OpenMagnetics/Lab/hardware/relay-board-revB/renders/07_closeup_dut_clamp.png

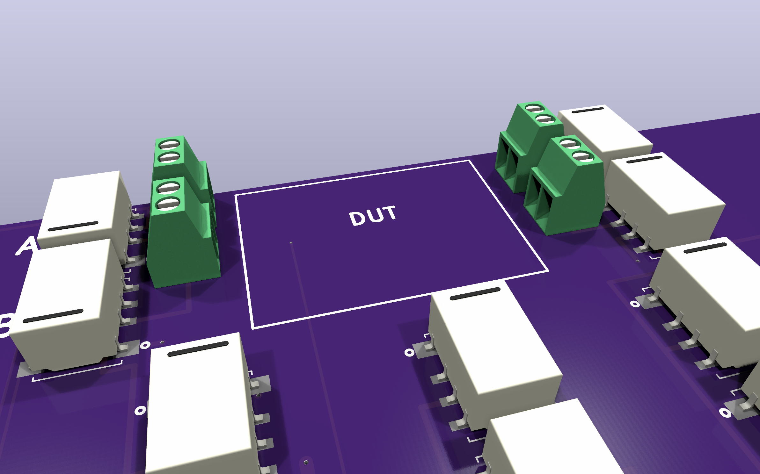
hardware/relay-board-revB/renders/07_closeup_dut_clamp.png
