OpenMagnetics/Lab/hardware/relay-board-revB/renders/03_top.png

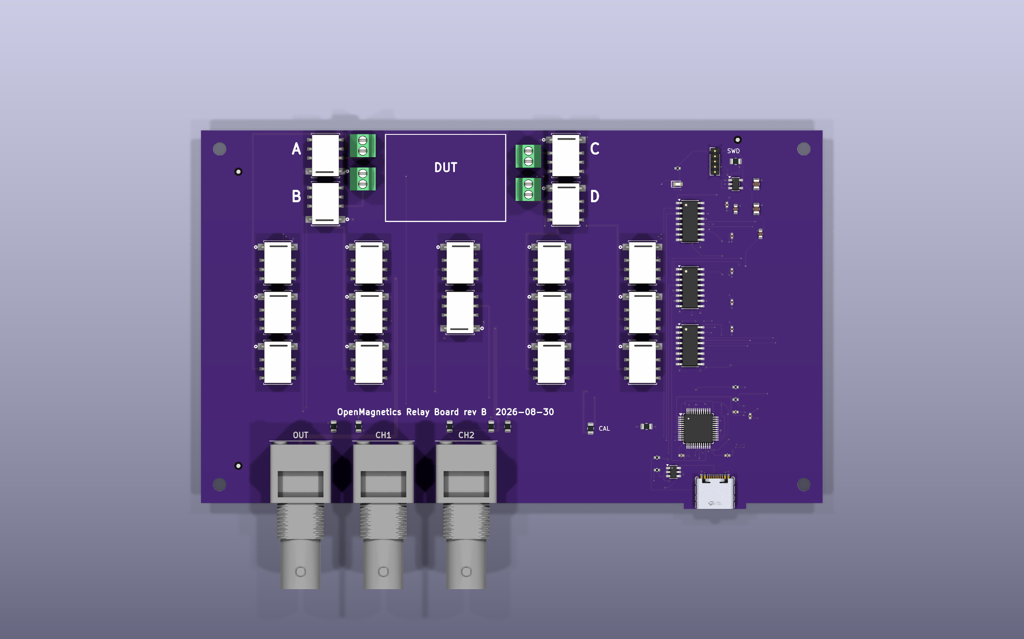
hardware/relay-board-revB/renders/03_top.png
