OpenMagnetics/Lab/hardware/B-WIC-Adapter/board_render.png

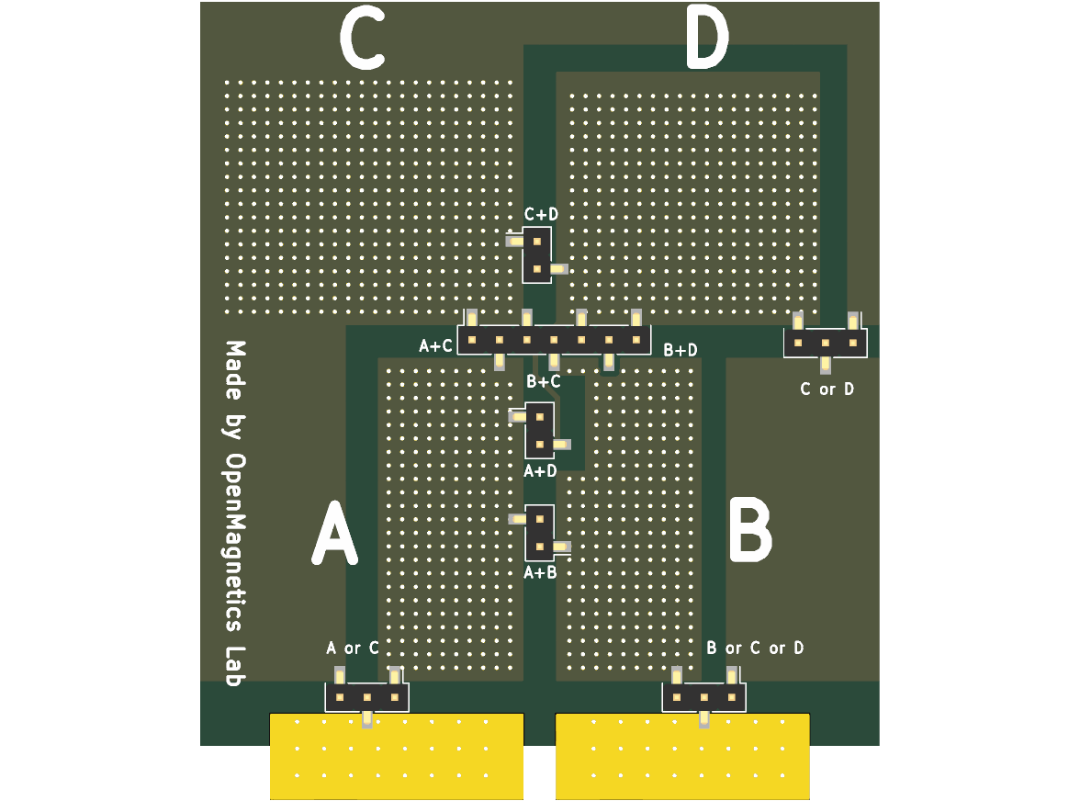
hardware/B-WIC-Adapter/board_render.png
