OpenMagnetics/Lab/hardware/B-WIC-Adapter/relay_board_render.png

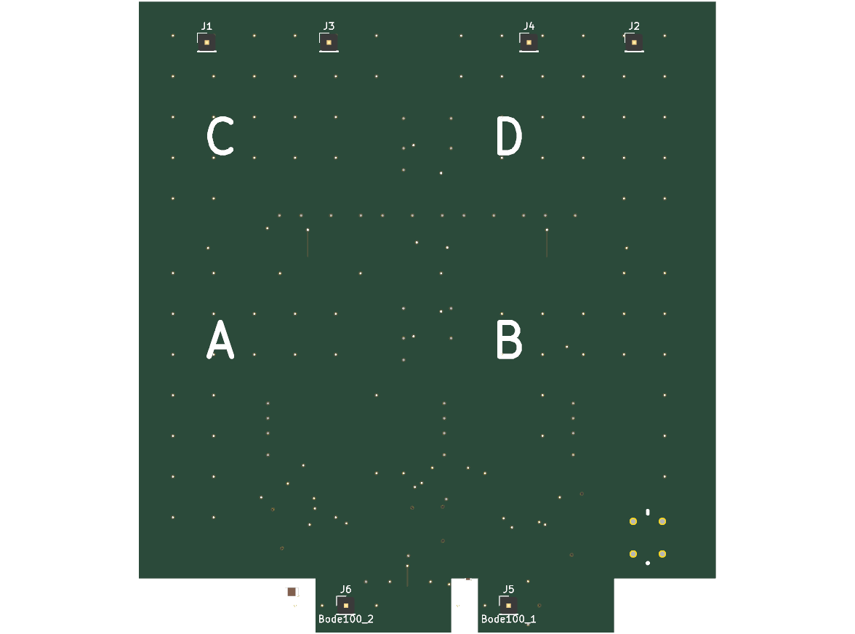
hardware/B-WIC-Adapter/relay_board_render.png
