OpenMagnetics/Lab/hardware/relay-board-revB/board_render_final.png

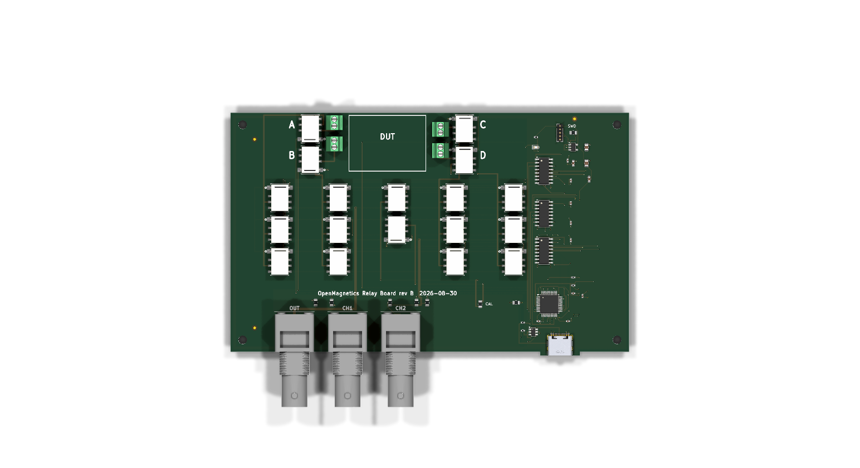
hardware/relay-board-revB/board_render_final.png
