OpenMagnetics/Lab/hardware/relay-board-revB/board_render_full.png

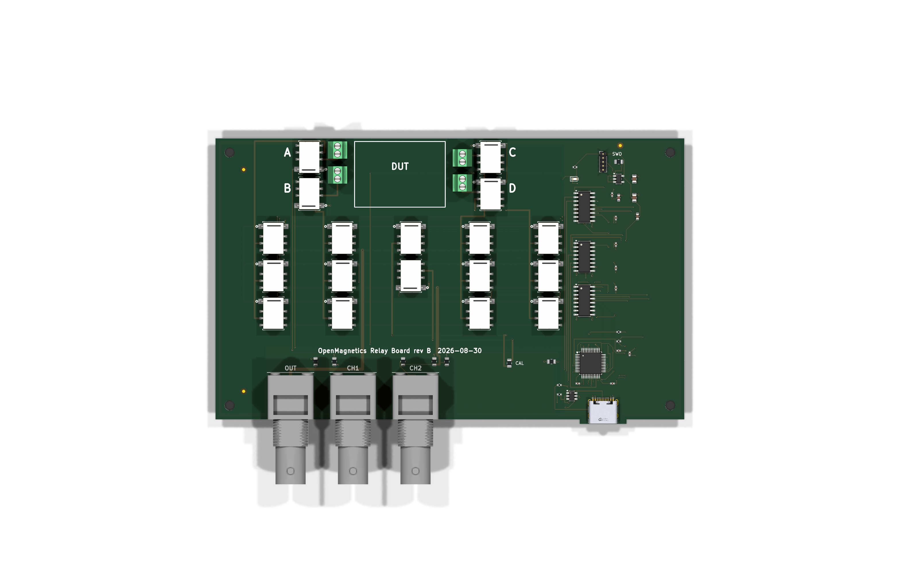
hardware/relay-board-revB/board_render_full.png
