OpenMagnetics/Lab/hardware/relay-board-revB/renders/01_hero_front_left.png

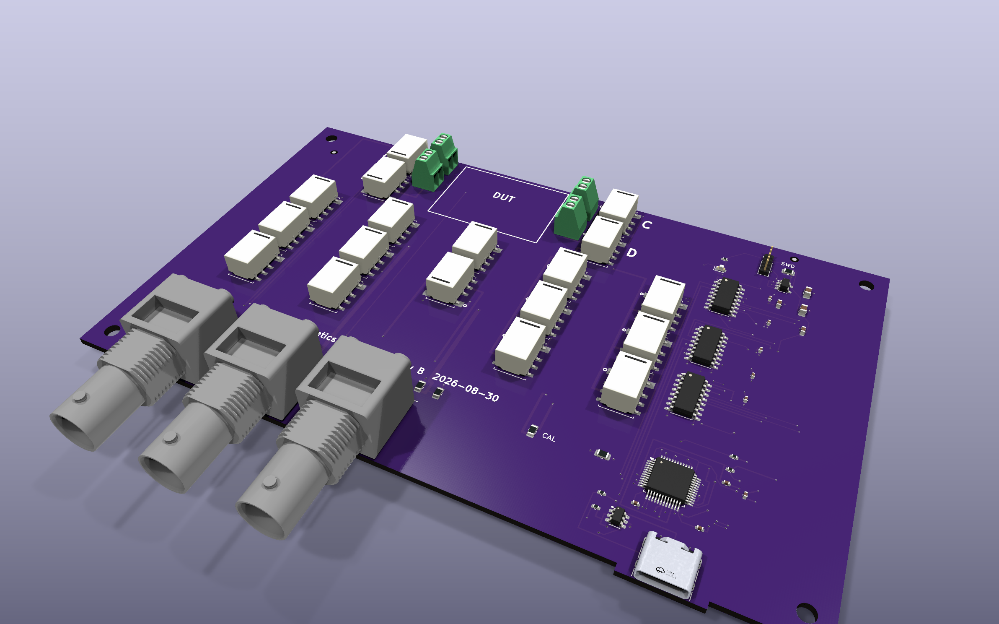
hardware/relay-board-revB/renders/01_hero_front_left.png
