OpenMagnetics/Lab/hardware/relay-board-revB/renders/02_back_right.png

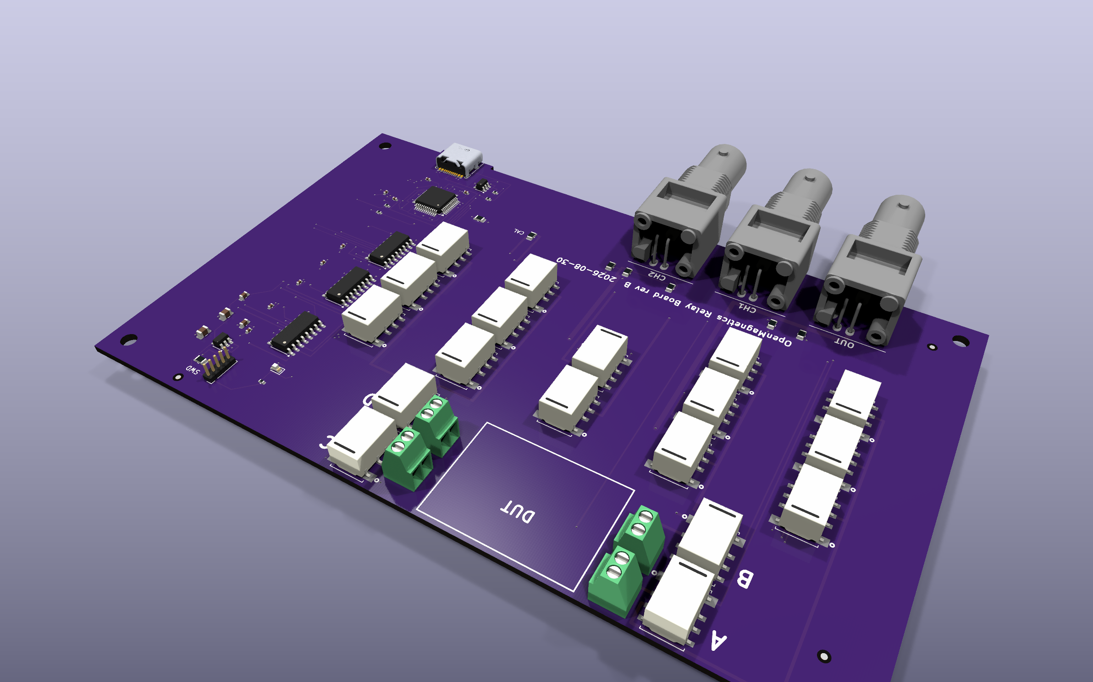
hardware/relay-board-revB/renders/02_back_right.png
