OpenMagnetics/Lab/hardware/relay-board-revB/renders/04_bottom.png

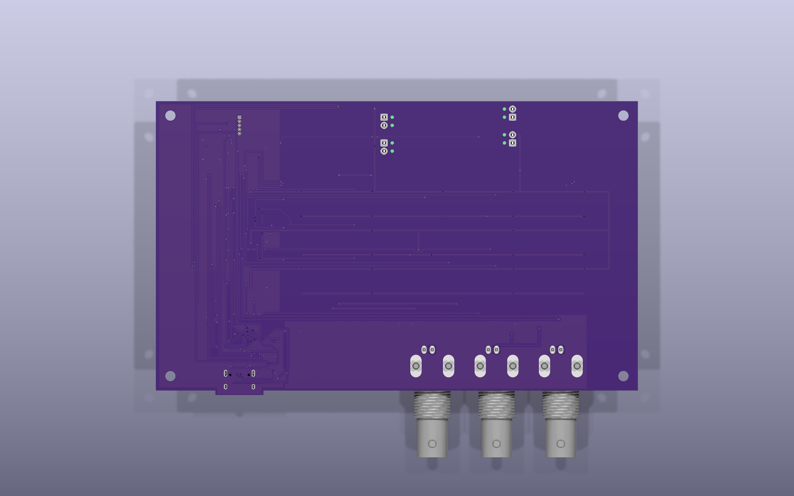
hardware/relay-board-revB/renders/04_bottom.png
