OpenMagnetics/Lab/hardware/relay-board-revB/renders/05_low_bnc_edge.png

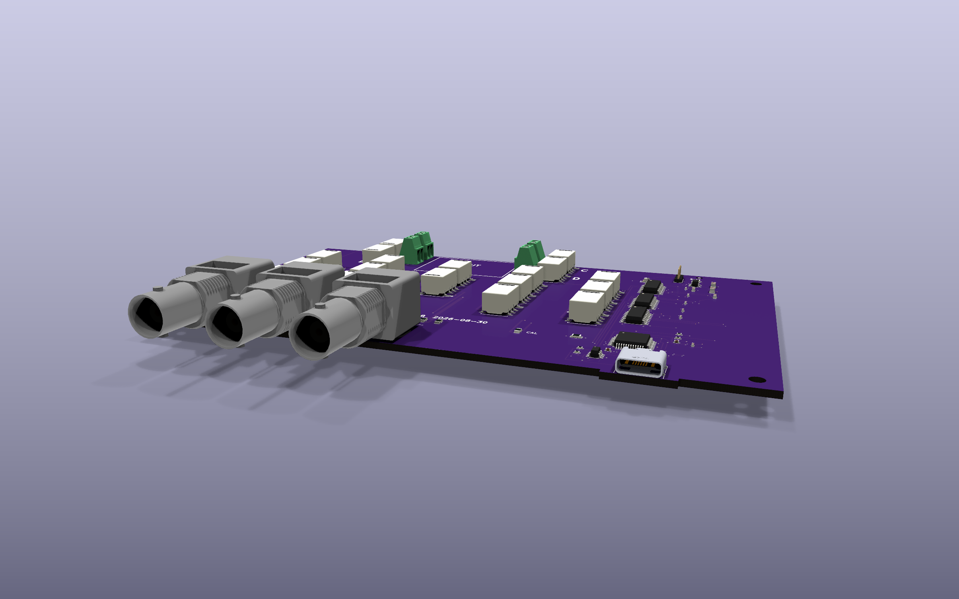
hardware/relay-board-revB/renders/05_low_bnc_edge.png
