OpenMagnetics/Lab/hardware/relay-board-revB/renders/06_closeup_mcu_usb.png

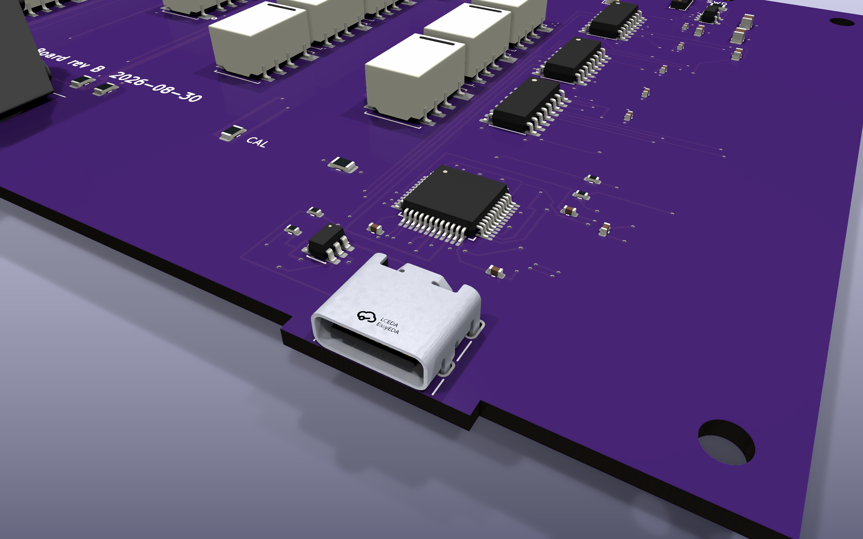
hardware/relay-board-revB/renders/06_closeup_mcu_usb.png
