OpenMagnetics/Lab/hardware/relay-board-revB/renders/08_side_usb.png

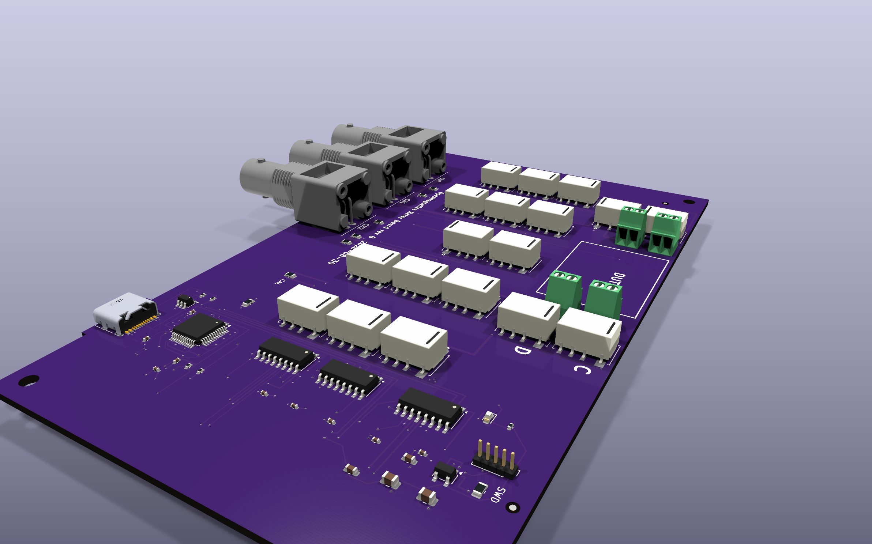
hardware/relay-board-revB/renders/08_side_usb.png
