OpenMagnetics/Lab/hardware/relay-board-revB/renders/09_front_bnc_text.png

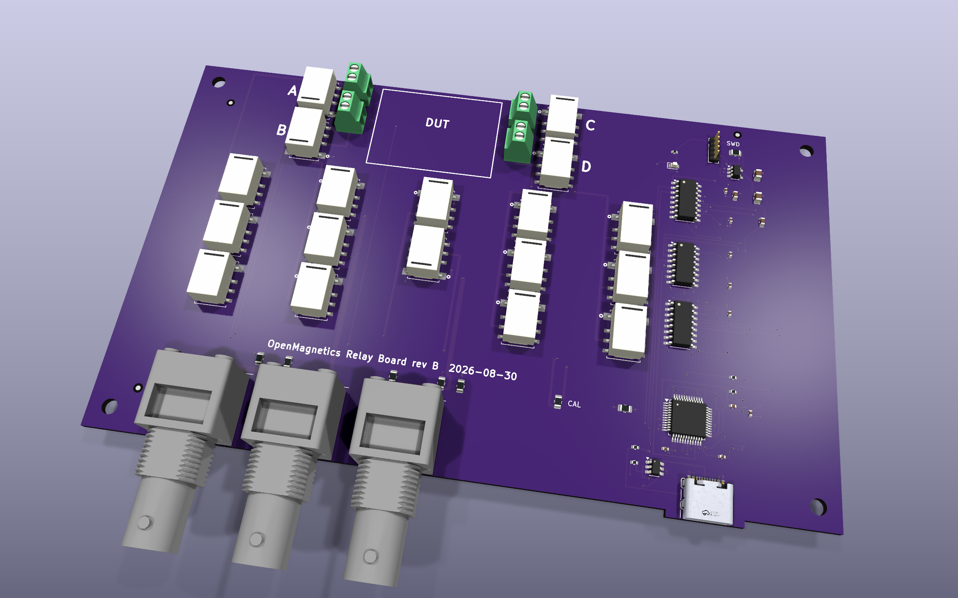
hardware/relay-board-revB/renders/09_front_bnc_text.png
