OpenMagnetics/Lab/hardware/relay-board-revB/renders/10_front_text_closeup.png

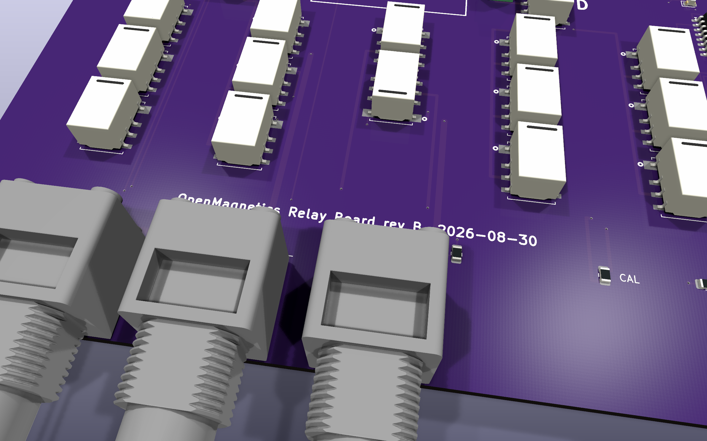
hardware/relay-board-revB/renders/10_front_text_closeup.png
