OpenMagnetics/Lab/hardware/relay-board-revB/usb_corner_check.png

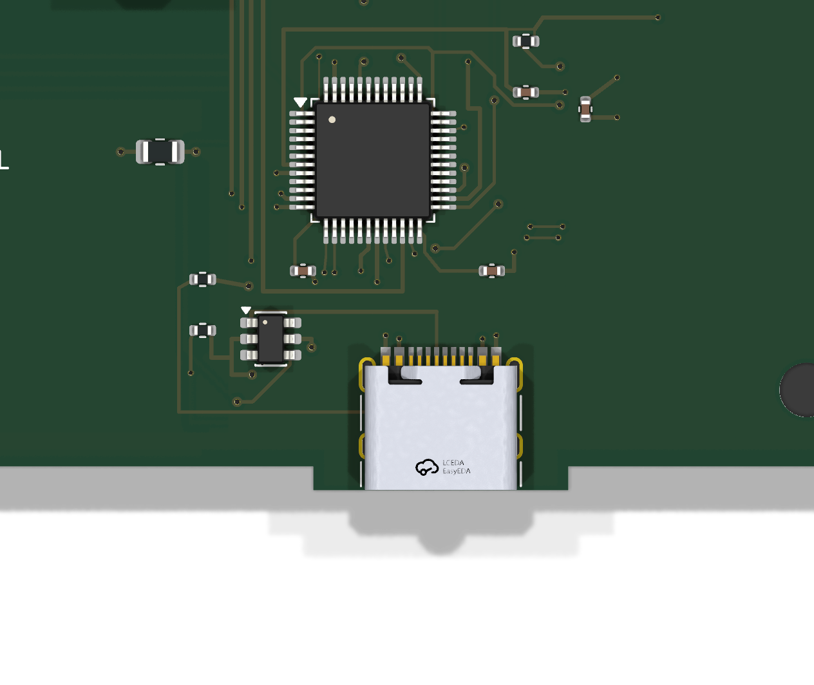
hardware/relay-board-revB/usb_corner_check.png
