OpenMagnetics/Lab/hardware/B-WIC-Adapter/relay_board_BOM.md

# OpenMagnetics Automated Relay Board - Bill of Materials
# Generated by generate_board.py

| Ref | Qty | Value | Description | Package | Part Number |
|-----|-----|---|---|---|---|
| U1 | 1 | STM32F042K6T6 | ARM Cortex-M0 MCU, crystal-less USB | LQFP-32 | STM32F042K6T6 |
| U2 | 1 | ULN2003A | 7-ch Darlington driver (K1-K7) | SOIC-16 | ULN2003ADR |
| U3 | 1 | ULN2003A | 7-ch Darlington driver (K8-K9) | SOIC-16 | ULN2003ADR |
| U4 | 1 | AMS1117-3.3 | 3.3V LDO regulator | SOT-223 | AMS1117-3.3 |
| K1-K9 | 9 | G6K-2F-RF-S DC4.5 | DPDT RF signal relay | SMD | G6K-2F-RF-S DC4.5 |
| J1 | 1 | USB-C | USB Type-C receptacle | SMD | USB4105-GF-A |
| J2 | 1 | Bode100_2 | Edge connector pad (left) | Custom | - |
| J3 | 1 | Bode100_1 | Edge connector pad (right) | Custom | - |
| J4 | 1 | WAGO 2060 | Spring terminal - DUT A | SMD | 2060-451/998-404 |
| J5 | 1 | WAGO 2060 | Spring terminal - DUT B | SMD | 2060-451/998-404 |
| J6 | 1 | WAGO 2060 | Spring terminal - DUT C | SMD | 2060-451/998-404 |
| J7 | 1 | WAGO 2060 | Spring terminal - DUT D | SMD | 2060-451/998-404 |
| C1-C3 | 3 | 100nF | Decoupling, STM32 | 0402 | - |
| C4,C5 | 2 | 100nF | Decoupling, ULN2003A | 0402 | - |
| C6-C14 | 9 | 100nF | Decoupling, relay coils | 0402 | - |
| C15 | 1 | 10uF | Bulk, 5V rail | 0805 | - |
| C16 | 1 | 10uF | Bulk, 3.3V rail | 0805 | - |
| C17 | 1 | 1uF | USB VBUS filter | 0402 | - |
| R1,R2 | 2 | 5.1k | USB-C CC pull-down | 0402 | - |
| R3 | 1 | 10k | NRST pull-up | 0402 | - |
| R4 | 1 | 10k | BOOT0 pull-down | 0402 | - |

## Total unique parts: 11
## Total component count: ~40
