OpenMagnetics/Lab/hardware/relay-board-revB/relay_board_BOM.md

# OpenMagnetics Relay Board rev B -- Bill of Materials
# GENERATED by generate_bom.py from relay_board.xml -- do not edit.

| Refs | Qty | Value | Part number | Notes |
|---|-----|---|---|---|
| C1,C2 | 2 | 22uF | - | C_0805_2012Metric |
| C3,C4 | 2 | 1uF | - | C_0603_1608Metric |
| C5-C15 | 9 | 100nF | - | C_0402_1005Metric |
| D1 | 1 | PWR | - | LED_0603_1608Metric |
| D2 | 1 | USBLC6-2SC6 | ST USBLC6-2SC6 | USB 2.0 ESD array, IEC 61000-4-2 level 4 |
| J1 | 1 | USB-C | HRO TYPE-C-31-M-12 | USB-C receptacle, USB 2.0, 16 pin |
| J2 | 1 | DUT A | Phoenix 1725656 (MPT 0,5/2-2,54) | spring-cage DUT clamp, 2 positions, wire entry from top edge |
| J3 | 1 | DUT B | Phoenix 1725656 (MPT 0,5/2-2,54) | spring-cage DUT clamp, 2 positions, wire entry from top edge |
| J4 | 1 | DUT C | Phoenix 1725656 (MPT 0,5/2-2,54) | spring-cage DUT clamp, 2 positions, wire entry from top edge |
| J5 | 1 | DUT D | Phoenix 1725656 (MPT 0,5/2-2,54) | spring-cage DUT clamp, 2 positions, wire entry from top edge |
| J6 | 1 | BNC SOURCE | Amphenol B6252HB-NPP3G-50 | 50R right-angle BNC jack |
| J7 | 1 | BNC CH1 | Amphenol B6252HB-NPP3G-50 | 50R right-angle BNC jack |
| J8 | 1 | SWD | CNC Tech 3220-05-0100-00 | 1.27 mm SWD header |
| J9 | 1 | BNC CH2 | Amphenol B6252HB-NPP3G-50 | 50R right-angle BNC jack |
| K1-K18 | 18 | G6K-2F-RF-S DC5 | Omron G6K-2F-RF-S DC5 | high-frequency DPDT relay, 5 V coil |
| R1,R2 | 2 | 5.1k | - | R_0402_1005Metric |
| R10 | 1 | 1k | - | R_0402_1005Metric |
| R12 | 1 | 1k 0.1% | Vishay TNPW08051K00BEEA | bridge RV1: 1k 0.1% 25 ppm thin film |
| R13,R16 | 2 | 47R 0.1% | Vishay TNPW080547R0BEEA | bridge RV2/RC2: 47R 0.1% 25 ppm thin film |
| R14,R15 | 2 | 4R7 | Vishay TNPW08054R70BEEA | bridge RC1 shunt half: 4R7 0.1% (two in parallel = 2R35) |
| R3,R4 | 2 | 10k | - | R_0402_1005Metric |
| R5 | 1 | 100R 0.1% | Vishay TNPW0805100RBEEA | LOAD standard: 100R 0.1% 25 ppm thin film |
| R9,R11 | 2 | 0R | - | R_0805_2012Metric |
| U1 | 1 | STM32F072CBT6 | ST STM32F072CBT6 | Cortex-M0, 128K flash, crystal-less USB (HSI48 + CRS) |
| U2,U3,U4 | 3 | TBD62003APG | Toshiba TBD62003AFG | 7ch DMOS sink driver (SOIC-16 = AFG suffix) |
| U5 | 1 | AP2112K-3.3 | Diodes AP2112K-3.3TRG1 | 3.3 V 600 mA LDO, 250 mV dropout |

Total placements: 60

Notes:
- All components on the top side; single-sided assembly.
- R5 is the calibration LOAD standard: substitutions must hold 0.1%
  and low TCR or every calibrated measurement inherits the error.
- Relays: G6K-2F-RF-S DC5 (5 V coil suits the USB-derived +5 V rail
  through the TBD62003's ~0.15 V drop). ~26 week lead time -- order first.
- USB VID/PID are pid.codes test values; register before distributing.
