OpenMagnetics/Lab/hardware/relay-board-revB/relay_board_JLC_BOM.xlsx

Comment | Designator | Footprint | JLCPCB Part #（optional）
CL21A226MAQNNNE | C1,C2 | C0805 | C45783
CL10A105KB8NNNC | C3,C4 | C0603 | C15849
CL05B104KO5NNNC | C5,C6,C7,C8,C9,C10,C11,C12,C15 | C0402 | C1525
KT-0603R | D1 | LED0603 | C2286
USBLC6-2SC6 | D2 | SOT-23-6 | C2827654
TYPE-C-31-M-12 | J1 | USB_C_Receptacle_HRO_TYPE-C-31-M-12 | C165948
G6K-2F-Y-TR DC5 | K1,K2,K3,K4,K5,K6,K7,K8,K9,K10,K11,K12,K13,K14,K15,K16,K17,K18 | Relay_Omron_G6K-2F-RF-S | C47190
0402WGF5101TCE | R1,R2 | R0402 | C25905
0402WGF1001TCE | R10 | R0402 | C11702
TNPW08051K00BEEA | R12 | R0805 | C2073519
0805W8F470JT5E | R13,R16 | R0805 | C17714
0805W8F470KT5E | R14,R15 | R0805 | C17675
0402WGF1002TCE | R3,R4 | R0402 | C25744
TNPW0805100RBEEA | R5 | R0805 | C2073390
0805W8F0000T5E | R9,R11 | R0805 | C17477
STM32F072CBT6 | U1 | LQFP-48 | C81720
TBD62003AFG(Z,EL) | U2,U3,U4 | SOIC-16 | C163227
AP2112K-3.3TRG1 | U5 | SOT-23-5 | C23380830
