OpenMagnetics/Lab/hardware/B-WIC-Adapter/relay_board.pdf

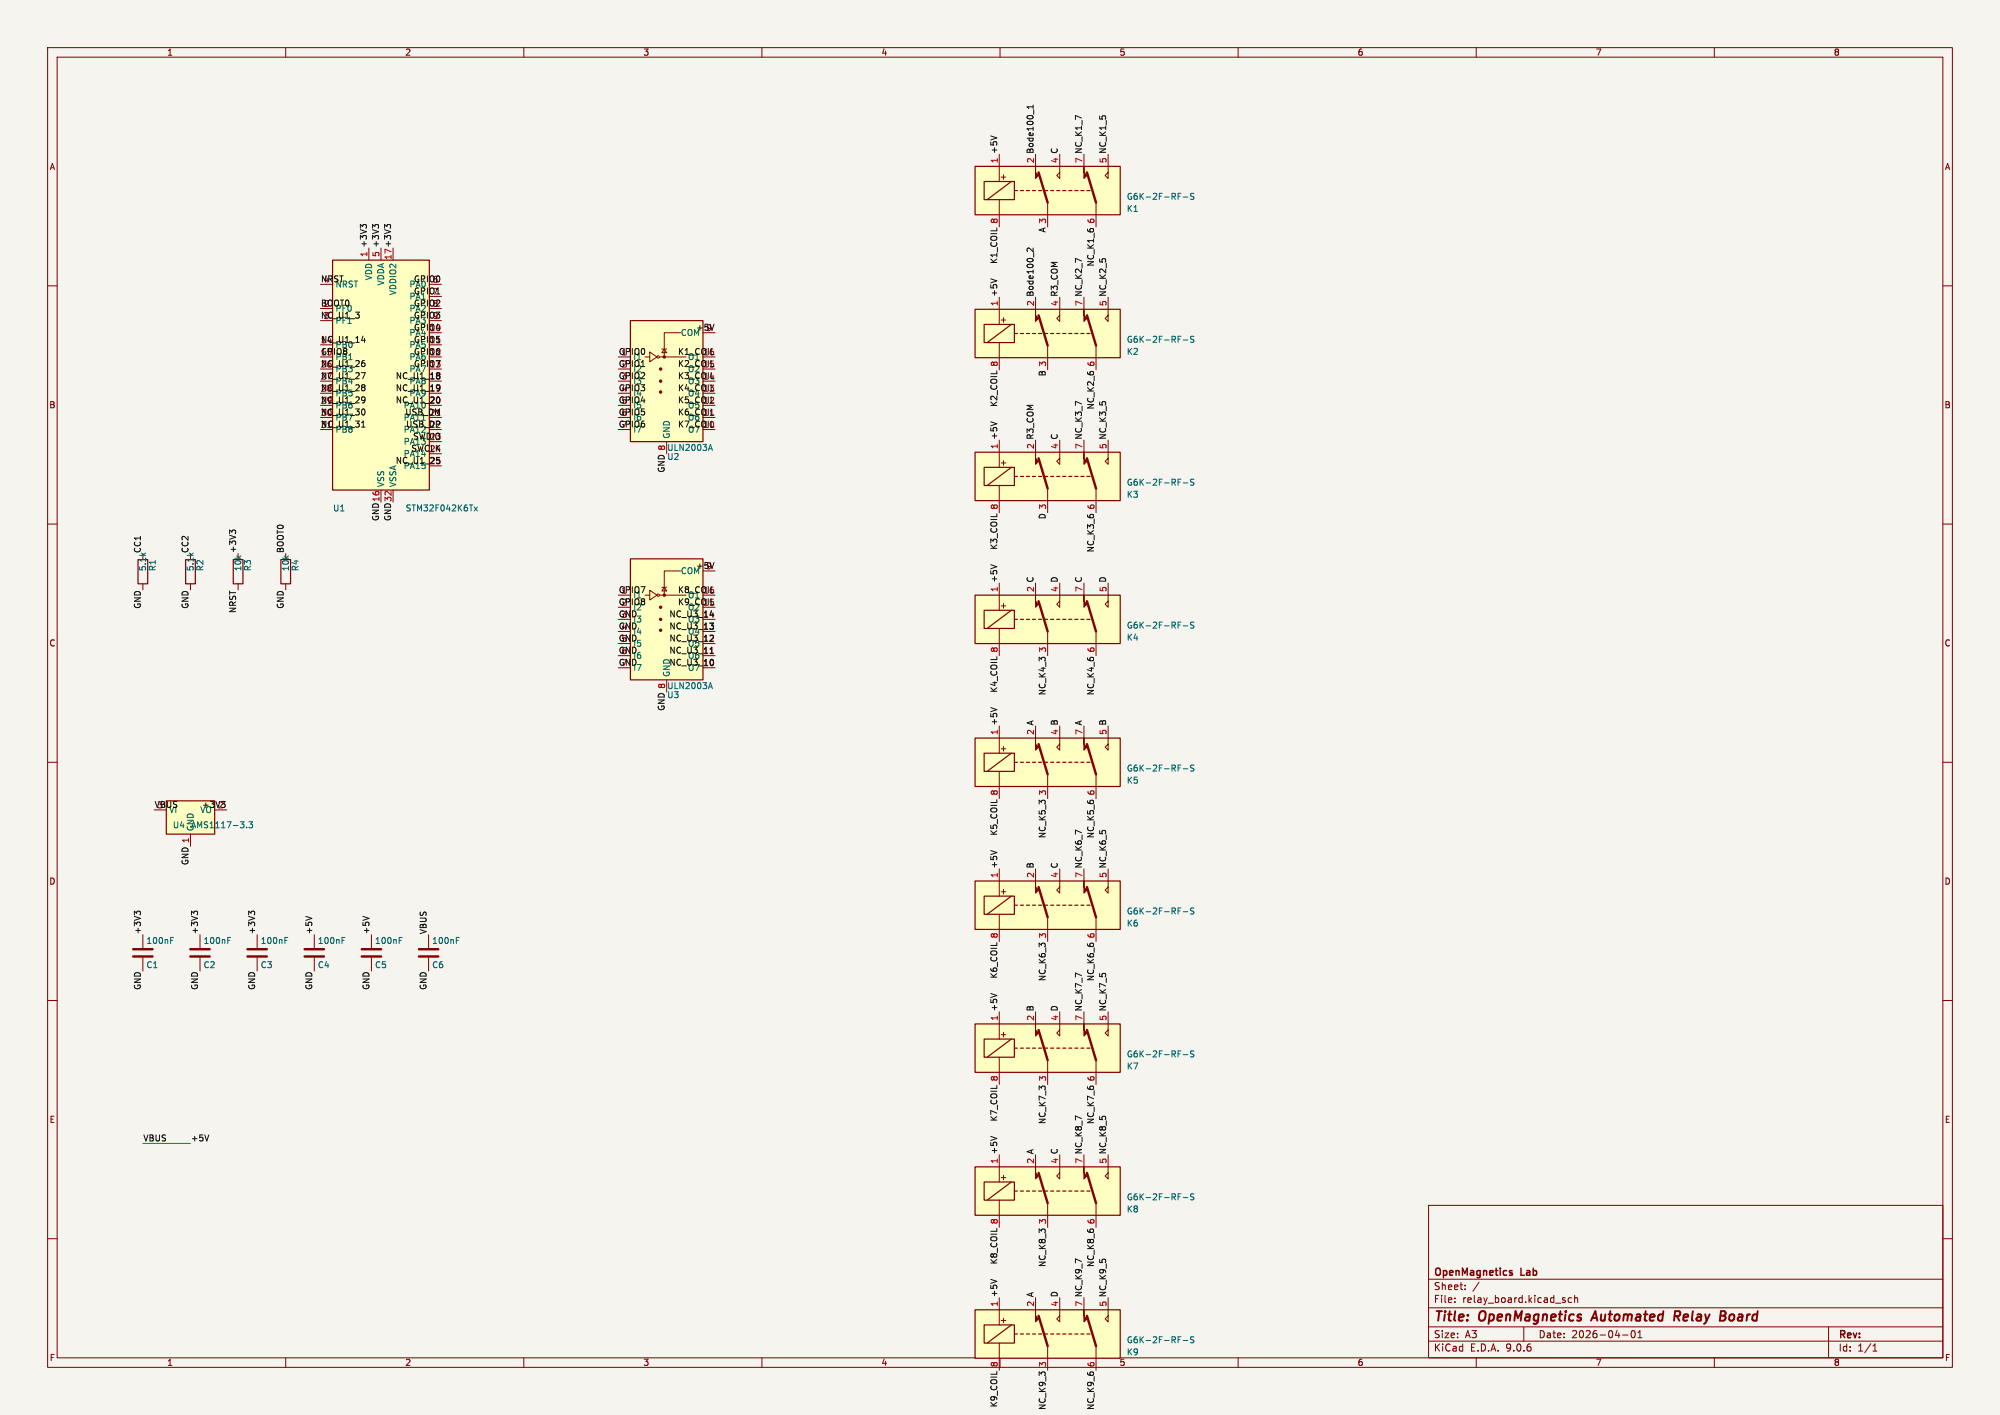
[picture p16: page 1]

Id: 1/1 Title: OpenMagnetics Automated Relay Board
