OpenMagnetics/Lab/(list of files, drawings)

Other design files:
hardware/B-WIC-Adapter/relay_board.dsn
hardware/relay-board-revB2/relay_board.dsn
hardware/relay-board-revB/relay_board.dsn
