OpenMagnetics/Lab/hardware/relay-board-revB2/relay_board.kicad_pcb

## KiCad design hardware/relay-board-revB2/relay_board.kicad_pcb (2026-10-01)

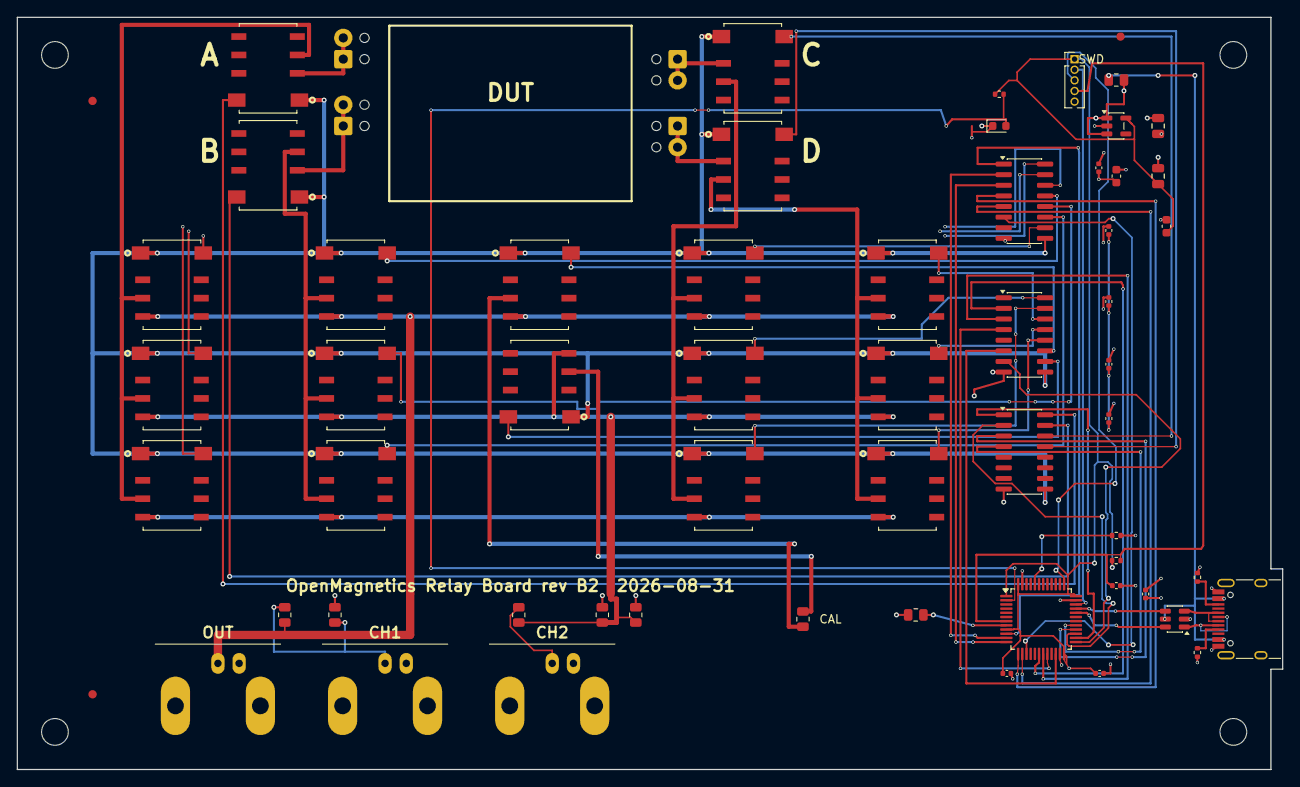
[picture p17: board hardware/relay-board-revB2/relay_board.kicad_pcb from above]

Board: 4 copper layers, 151.4 x 90.0 mm, 67 parts (0 on the bottom side), 67 nets.

Parts:
C1, C2: C_0805_2012Metric
C3, C4: C_0603_1608Metric
C5, C6, C7, C8, C9, C10, C11, C12, C15: C_0402_1005Metric
D1: LED_0603_1608Metric
D2: SOT-23-6
FID1, FID2, FID3: Fiducial_1mm_Mask2mm
H1, H2, H3, H4: MountingHole_3.2mm_M3
J1: USB_C_Receptacle_HRO_TYPE-C-31-M-12
J2, J3, J4, J5: TerminalBlock_Phoenix_MPT-0,5-2-2.54_1x02_P2.54mm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; TerminalBlock_Phoenix_MPT-0,5-2-2.54_1x02_P2.54mm_Horizontal
J6, J7, J9: BNC_Amphenol_B6252HB-NPP3G-50_Horizontal
J8: PinHeader_1x05_P1.27mm_Vertical
K1, K2, K3, K4, K5, K6, K7, K8, K9, K10, K11, K12, K13, K14, K15, K16, K17, K18: G6K-2F-RF-S; Relay_Omron_G6K-2F-RF-S
R1, R2, R3, R4, R10: R_0402_1005Metric
R5, R9, R11, R12, R13, R14, R15, R16: R_0805_2012Metric
U1: LQFP-48_7x7mm_P0.5mm
U2, U3, U4: SOIC-16_3.9x9.9mm_P1.27mm
U5: SOT-23-5

Connections:
/+3V3: C2.1, C4.1, C8.1, C9.1, J8.1, R3.1, R10.1, U1.1, U1.9, U1.24, U1.36, U1.48, U5.5
/+5V: C1.1, C3.1, C5.1, C6.1, C7.1, C10.1, C11.1, C12.1, K1.1, K2.1, K3.1, K4.1, K5.1, K6.1, K7.1, K8.1, K9.1, K10.1, K11.1, K12.1, K13.1, K14.1, K15.1, K16.1, K17.1, K18.1, R9.2, U2.9, U3.9, U4.9, U5.1, U5.3
/AGND: J6.2, J7.2, J9.2, R11.1, R13.2, R14.2, R15.2
/BOOT0: R4.1, U1.44
/CAL_E: K13.3, R5.1
/CAL_F: K14.3, R5.2
/CC1: J1.A5, R1.1
/CC2: J1.B5, R2.1
/CH1_NODE: J7.1, R12.2, R13.1
/CH2_NODE: J9.1, R16.2
/DUT_A: J2.1, J2.2, K15.2
/DUT_B: J3.1, J3.2, K16.2
/DUT_C: J4.1, J4.2, K17.2
/DUT_D: J5.1, J5.2, K18.2
/GND: C1.2, C2.2, C3.2, C4.2, C5.2, C6.2, C7.2, C8.2, C9.2, C10.2, C11.2, C12.2, C15.2, D1.1, D2.2, J1.A1, J1.A12, J1.B1, J1.B12, J1.S1, J8.5, R1.2, R2.2, R4.2, R11.2, U1.8, U1.23, U1.35, U1.47, U2.8, U3.8, U4.8, U5.2
/GPIO1: U1.10, U2.1
/GPIO2: U1.11, U2.2
/GPIO3: U1.12, U2.3
/GPIO4: U1.13, U2.4
/GPIO5: U1.14, U2.5
/GPIO6: U1.15, U2.6
/GPIO7: U1.16, U2.7
/GPIO8: U1.17, U3.1
/GPIO9: U1.18, U3.2
/GPIO10: U1.19, U3.3
/GPIO11: U1.20, U3.4
/GPIO12: U1.21, U3.5
/GPIO13: U1.22, U3.6
/GPIO14: U1.25, U3.7
/GPIO15: U1.26, U4.1
/GPIO16: U1.27, U4.2
/GPIO17: U1.28, U4.3
/GPIO18: U1.29, U4.4
/K1_COIL: K1.8, U2.16
/K2_COIL: K2.8, U2.15
/K3_COIL: K3.8, U2.14
/K4_COIL: K4.8, U2.13
/K5_COIL: K5.8, U2.12
/K6_COIL: K6.8, U2.11
/K7_COIL: K7.8, U2.10
/K8_COIL: K8.8, U3.16
/K9_COIL: K9.8, U3.15
/K10_COIL: K10.8, U3.14
/K11_COIL: K11.8, U3.13
/K12_COIL: K12.8, U3.12
/K13_COIL: K13.8, U3.11
/K14_COIL: K14.8, U3.10
/K15_COIL: K15.8, U4.16
/K16_COIL: K16.8, U4.15
/K17_COIL: K17.8, U4.14
/K18_COIL: K18.8, U4.13
/LED_A: D1.2, R10.2, U1.2
/NRST: C15.1, J8.4, R3.2, U1.7
/RAIL_HI: J6.1, K1.4, K4.4, K7.4, K10.4, K13.4, R12.1
/RAIL_LINK: K3.4, K6.4, K9.4, K12.4
/RAIL_LO: K2.4, K5.4, K8.4, K11.4, K14.4, R14.1, R15.1, R16.1
/SWCLK: J8.3, U1.37
/SWDIO: J8.2, U1.34
/TA: K1.3, K2.3, K3.3, K15.3
/TB: K4.3, K5.3, K6.3, K16.3
/TC: K7.3, K8.3, K9.3, K17.3
/TD: K10.3, K11.3, K12.3, K18.3
/USB_DM: D2.6, U1.32
/USB_DM_CON: D2.1, J1.A7, J1.B7
/USB_DP: D2.4, U1.33
/USB_DP_CON: D2.3, J1.A6, J1.B6
/VBUS: D2.5, J1.A4, J1.A9, J1.B4, J1.B9, R9.1
