OpenMagnetics/Lab/hardware/B-WIC-Adapter/relay_board.kicad_pcb

## KiCad design hardware/B-WIC-Adapter/relay_board.kicad_pcb (2026-10-01)

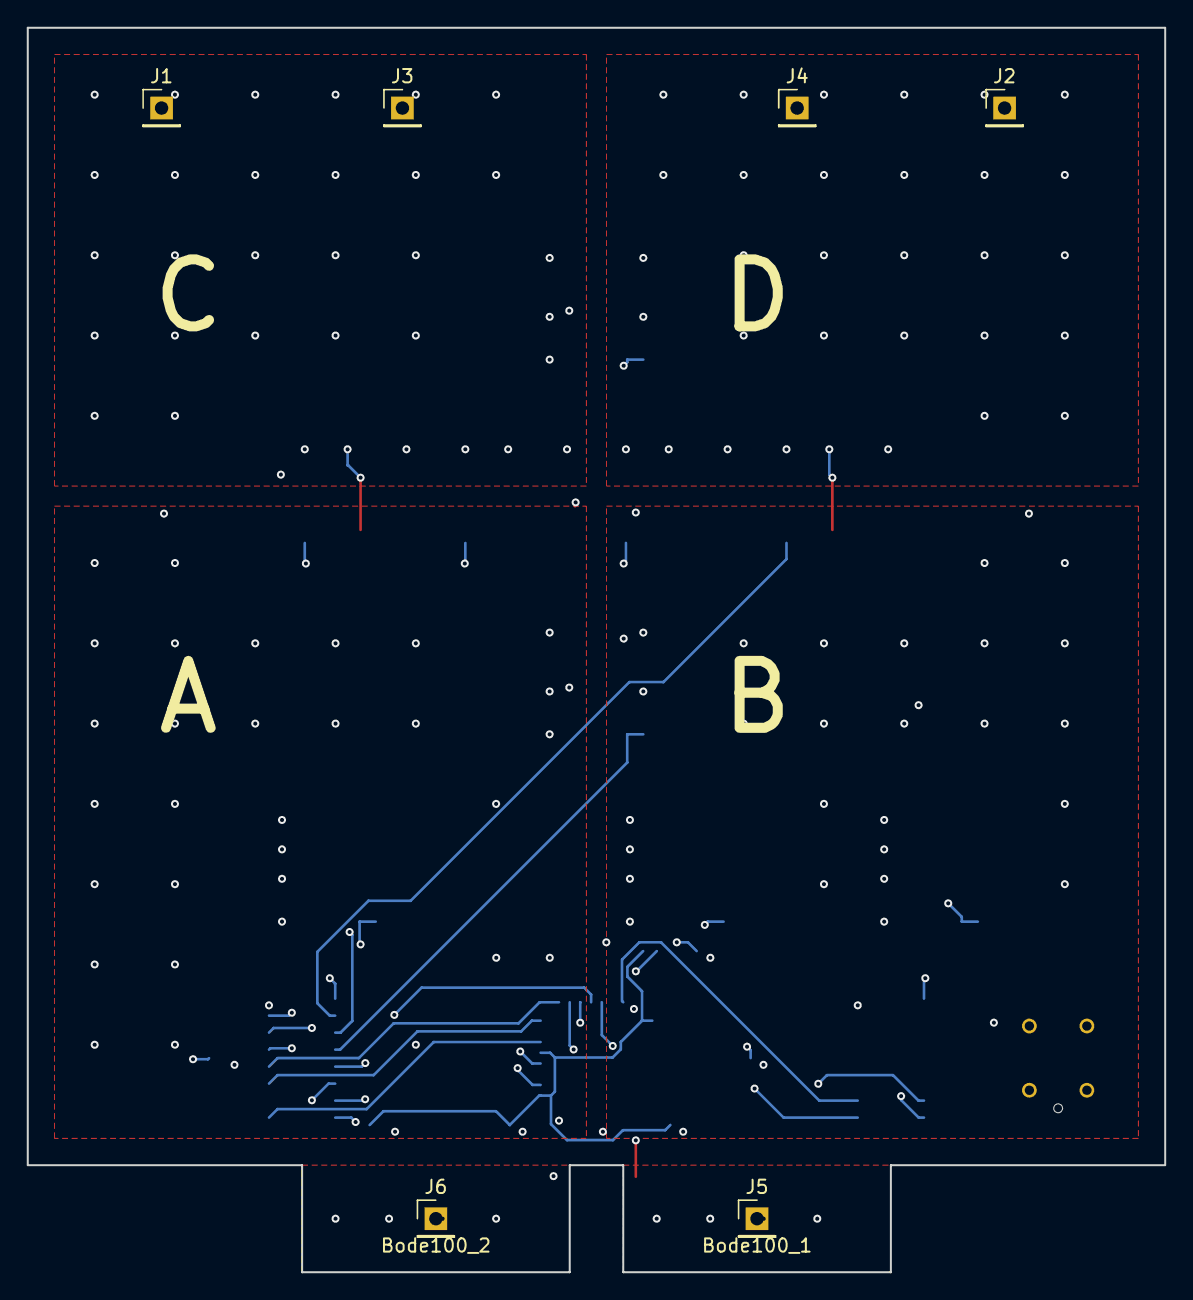
[picture p18: board hardware/B-WIC-Adapter/relay_board.kicad_pcb from above]

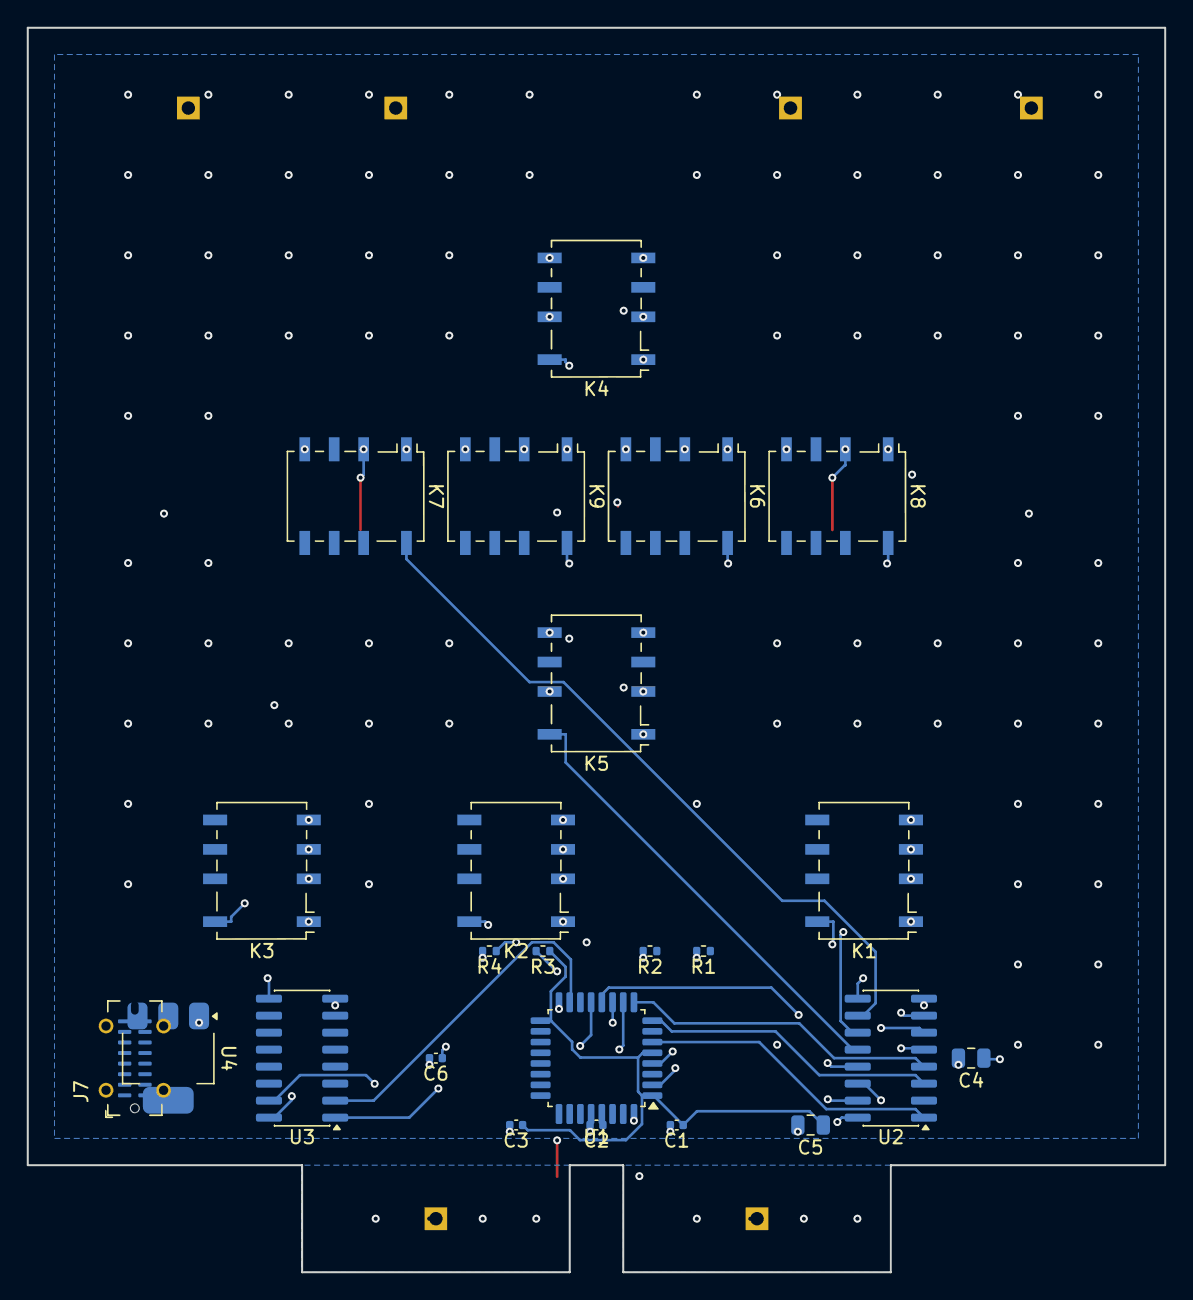
[picture p19: board hardware/B-WIC-Adapter/relay_board.kicad_pcb from below]

Board: 4 copper layers, 85.0 x 93.0 mm, 30 parts (24 on the bottom side), 30 nets.

Parts:
C1, C2, C3: 100nF; C_0402_1005Metric
C4, C5: 10uF; C_0805_2012Metric
C6: 1uF; C_0402_1005Metric
J1: A; PinHeader_1x01_P2.54mm_Vertical
J2: B; PinHeader_1x01_P2.54mm_Vertical
J3: C; PinHeader_1x01_P2.54mm_Vertical
J4: D; PinHeader_1x01_P2.54mm_Vertical
J5: Bode100_1; PinHeader_1x01_P2.54mm_Vertical
J6: Bode100_2; PinHeader_1x01_P2.54mm_Vertical
J7: USB-C; USB_C_Receptacle_G-Switch_GT-USB-7051x
K1, K2, K3, K4, K5, K6, K7, K8, K9: G6K-2F-RF-S; Relay_DPDT_Omron_G6K-2F-Y
R1, R2: 5.1k; R_0402_1005Metric
R3, R4: 10k; R_0402_1005Metric
U1: STM32F042K6Tx; LQFP-32_7x7mm_P0.8mm
U2, U3: ULN2003A; SOIC-16_3.9x9.9mm_P1.27mm
U4: AMS1117-3.3; SOT-223-3_TabPin2

Connections:
+3V3: C1.1, C2.1, C3.1, C5.1, R3.1, U1.1, U1.5, U1.17, U4.2
+5V: C4.1, C6.1, K1.1, K2.1, K3.1, K4.1, K5.1, K6.1, K7.1, K8.1, K9.1, U2.9, U3.9, U4.3
A: J1.1, K1.3, K5.2, K5.7, K8.2, K9.2
B: J2.1, K2.3, K5.4, K5.5, K6.2, K7.2
BOOT0: R4.1, U1.2
Bode100_1: J5.1, K1.2
Bode100_2: J6.1, K2.2
C: J3.1, K1.4, K3.4, K4.2, K4.7, K6.4, K8.4
D: J4.1, K3.3, K4.4, K4.5, K7.4, K9.4
GND: C1.2, C2.2, C3.2, C4.2, C5.2, C6.2, R1.2, R2.2, R4.2, U1.16, U1.32, U2.8, U3.3, U3.4, U3.5, U3.6, U3.7, U3.8, U4.1
GPIO0: U1.6, U2.1
GPIO1: U1.7, U2.2
GPIO2: U1.8, U2.3
GPIO3: U1.9, U2.4
GPIO4: U1.10, U2.5
GPIO5: U1.11, U2.6
GPIO6: U1.12, U2.7
GPIO7: U1.13, U3.1
GPIO8: U1.15, U3.2
K1_COIL: K1.8, U2.16
K2_COIL: K2.8, U2.15
K3_COIL: K3.8, U2.14
K4_COIL: K4.8, U2.13
K5_COIL: K5.8, U2.12
K6_COIL: K6.8, U2.11
K7_COIL: K7.8, U2.10
K8_COIL: K8.8, U3.16
K9_COIL: K9.8, U3.15
NRST: R3.2, U1.4
R3_COM: K2.4, K3.2
