OpenMagnetics/Lab/hardware/B-WIC-Adapter/adapter_leakage.kicad_pcb

## KiCad design hardware/B-WIC-Adapter/adapter_leakage.kicad_pcb (2024-12-09)

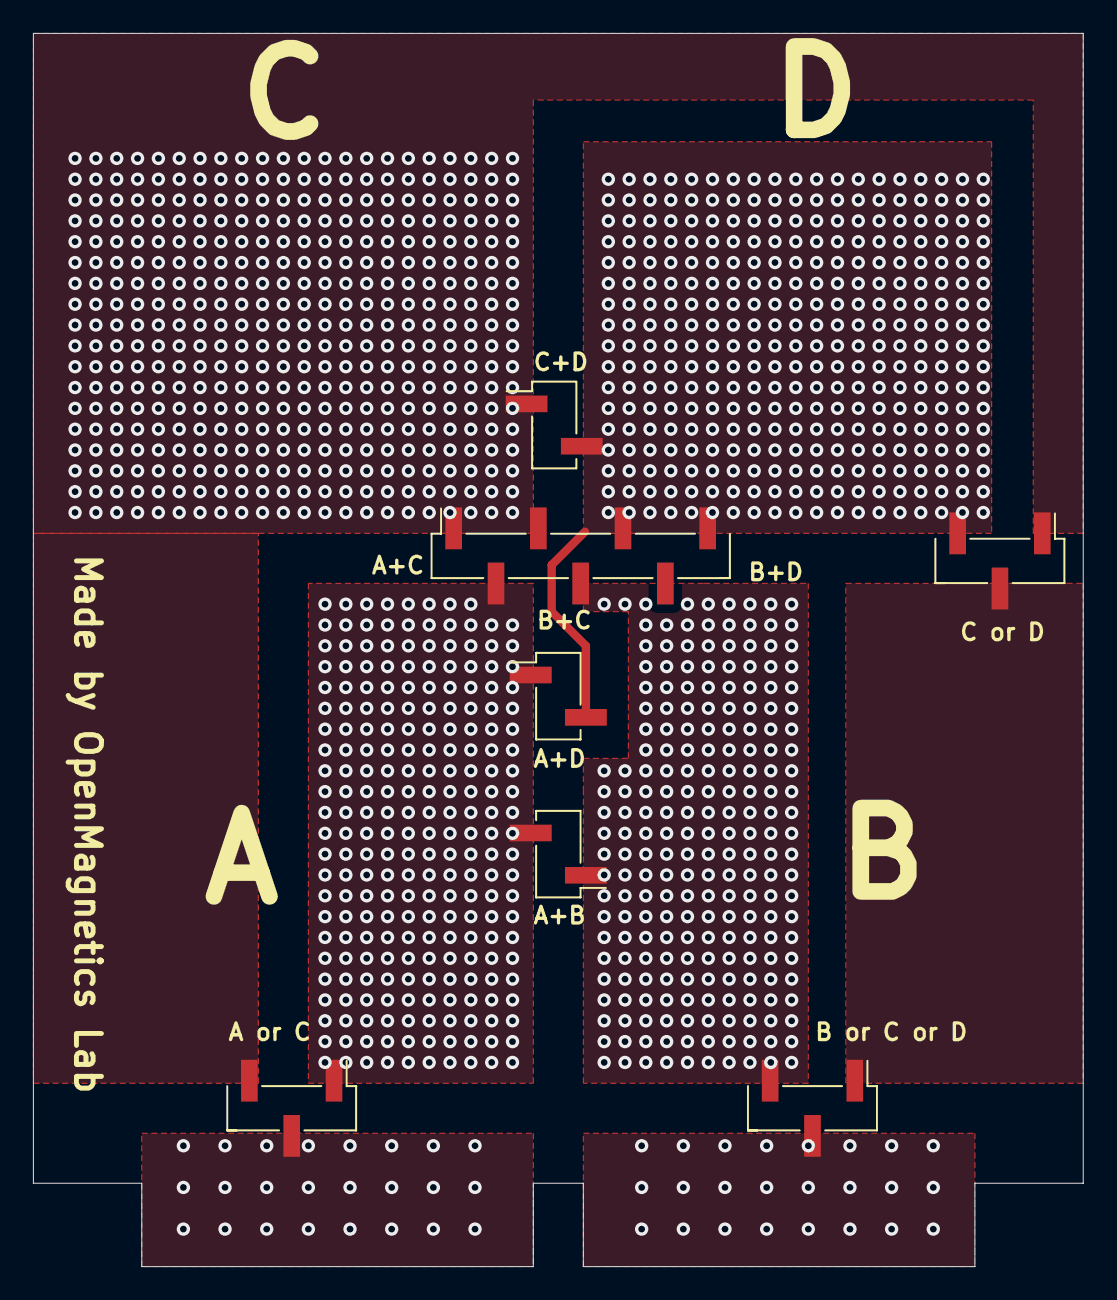
[picture p20: board adapter_leakage.kicad_pcb from above]

Board: 2 copper layers, 63.0 x 74.0 mm, 7 parts (0 on the bottom side), 5 nets.

Parts:
CC_Bottom1: Conn_01x02; PinHeader_1x02_P2.54mm_Vertical_SMD_Pin1Left
CC_Top1: Conn_01x02; PinHeader_1x02_P2.54mm_Vertical_SMD_Pin1Left
Cum_Dif1: Conn_01x07_MountingPin; PinHeader_1x07_P2.54mm_Vertical_SMD_Pin1Right
J1: Conn_01x02; PinHeader_1x02_P2.54mm_Vertical_SMD_Pin1Left
Pri_Sec_Left1: Conn_01x03; PinHeader_1x03_P2.54mm_Vertical_SMD_Pin1Left
Pri_Sec_Right1: Conn_01x03; PinHeader_1x03_P2.54mm_Vertical_SMD_Pin1Left
Secondary_multiplex1: Conn_01x03; PinHeader_1x03_P2.54mm_Vertical_SMD_Pin1Left

Connections:
/A: CC_Bottom1.2, Cum_Dif1.2, J1.1, Pri_Sec_Left1.1
/B: CC_Bottom1.1, Cum_Dif1.4, Pri_Sec_Right1.3
/C: CC_Top1.1, Cum_Dif1.1, Cum_Dif1.3, Pri_Sec_Left1.3, Secondary_multiplex1.1
/CorD: Pri_Sec_Right1.1, Secondary_multiplex1.2
/D: CC_Top1.2, Cum_Dif1.5, Cum_Dif1.7, J1.2, Secondary_multiplex1.3
