OpenMagnetics/Lab/(commit log)

2024-12-09 First draft of automated lab
    [adapter_leakage.kicad_pcb, adapter_leakage.kicad_sch]
2026-10-01 Add automated Bode 100 relay measurement board, firmware and drivers
    - hardware/relay-board-revB: 18-relay switching matrix with integrated
    B-WIC bridge, STM32F072 USB/SCPI controller; programmatic schematic/PCB
    generation, freerouting round trip, netlist truth-table verification,
    parasitic report, calibration simulation and fab/JLCPCB outputs
    - hardware/relay-board-revB2: follow-up layout iteration
    - hardware/B-WIC-Adapter: abandoned rev A, kept for reference
    - firmware: STM32F072 libopencm3 USB CDC-ACM SCPI firmware (relay_map.h)
    - scripts: RelayBoardController, per-path OSL calibration in
    Bode100Analyzer, recipe-based MagneticCharacterizer, TransformerModel
    with tests and synthe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
    [relay_board-B_Cu.gbl, relay_board-B_Mask.gbs, relay_board-B_Paste.gbp, relay_board-B_Silkscreen.gbo, relay_board-Edge_Cuts.gm1, relay_board-F_Cu.gtl, relay_board-F_Mask.gts, relay_board-F_Paste.gtp]
2026-10-01 Update CLAUDE.md, note revB2 BOOT0 fix after revB bring-up
    - CLAUDE.md: correct stale claims (argparse CLI, cache file naming,
    calibration ownership, relay_map.h sync is manual), drop nonexistent
    recipe tiers, document offline mode, revB2, fix_*.py scripts, tools/,
    firmware flash/dfu targets, test_model.py not being pytest-compatible.
    - revB2/TODO.md: blank STM32F072 doesn't enter DFU on empty flash; add a
    BOOT button/test pads (first revB board needed a hand-wired bridge).
    - .gitignore: firmware/build/.
2026-10-01 Firmware 1.1.1: SYST:DFU USB updates, dimmed status LED
    - SYST:DFU releases relays, detaches USB and reboots into the STM32F072
    ROM DFU bootloader (request carried across reset in .noinit RAM), so
    flashed boards update over USB without the BOOT0 strap.
    - scripts/update_firmware.py + `make -C firmware update`: SYST:DFU, flash
    and verify with STM32CubeProgrammer, confirm *IDN? after re-enumeration.
    RelayBoardController.enter_dfu() added.
    - Status LED: steady 2 % software PWM at 100 Hz instead of a full-brightness
    1 Hz blink; SysTick raised to 10 kHz (relay settle still 10 ms, measured).
    - Verified on both revB boards; revB2 TODO and CLAUDE.md updated.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
    [RelayBoardController.py, main.c, scpi.c, scpi.h, update_firmware.py]
2026-10-10 Firmware 1.1.2: honour SYST:DFU only after a software reset
    The bootloader request in .noinit RAM is now accepted only when the reset
    cause is a pure software reset (SFTRSTF without PORRSTF) and both the magic
    and its complement are present; reset flags are cleared at every boot.
    Power-up SRAM contents can therefore never trigger the ROM bootloader.
    Verified on hardware: SYST:DFU update round trip still works.
    [main.c, scpi.c]
2026-10-10 revB renders: add purple JLC views, fix USB-C connector in top views
    - renders/: ten 2400x1500 views (purple mask, HASL) from the fab master,
    rendered with kicad-cli 10 and the LCSC C165948 USB-C model aligned to
    the footprint body outline.
    - Regenerate the four older green top views, which had no USB-C model.
